Raigetix/EEG_EMT_32/Hardware/EEG/ADC.pdf

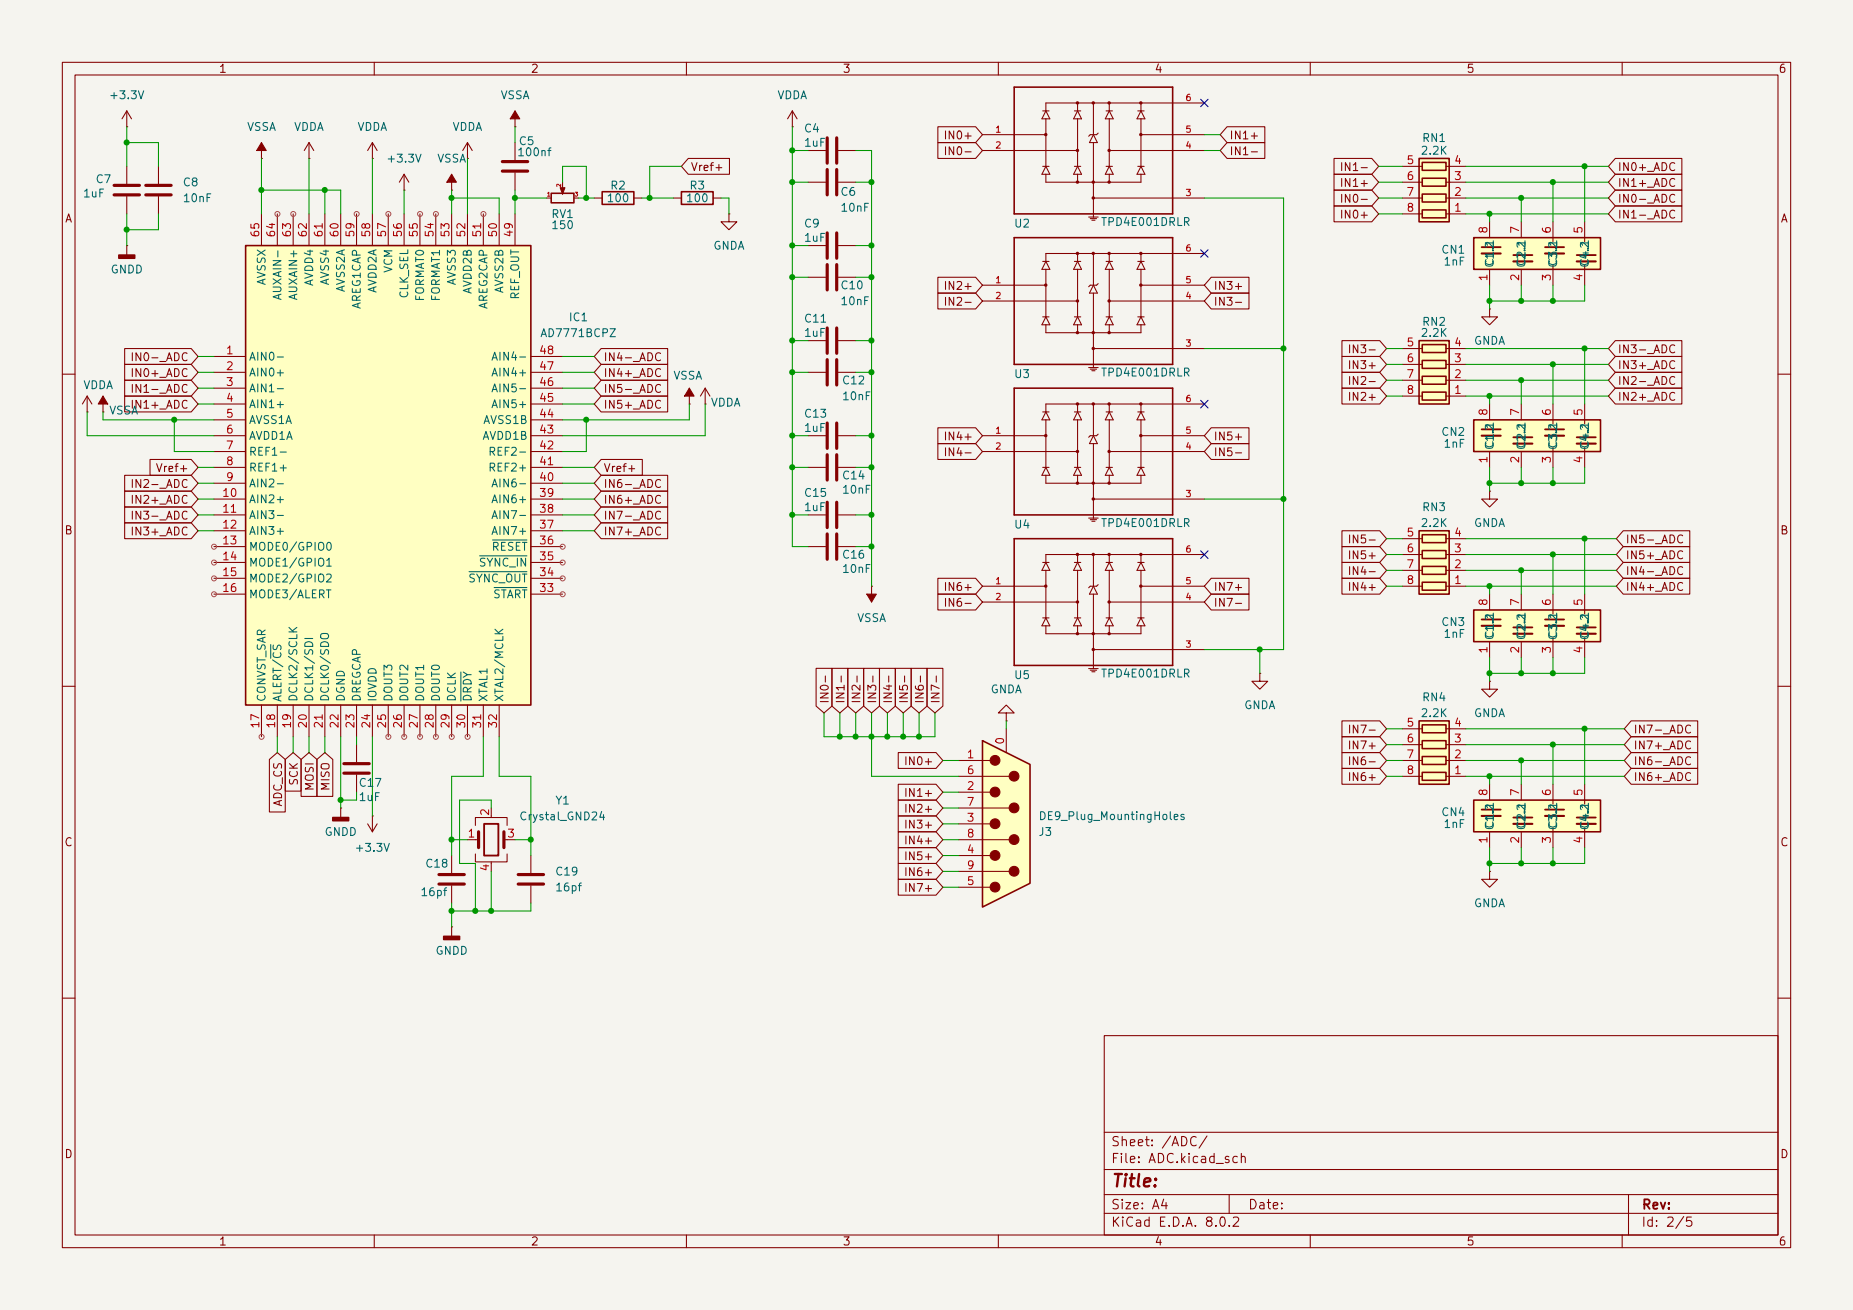
[picture p1: page 1]
