Raigetix/EEG_EMT_32/Hardware/EEG/EEG.kicad_pcb

## KiCad design Hardware/EEG/EEG.kicad_pcb (2025-01-11)

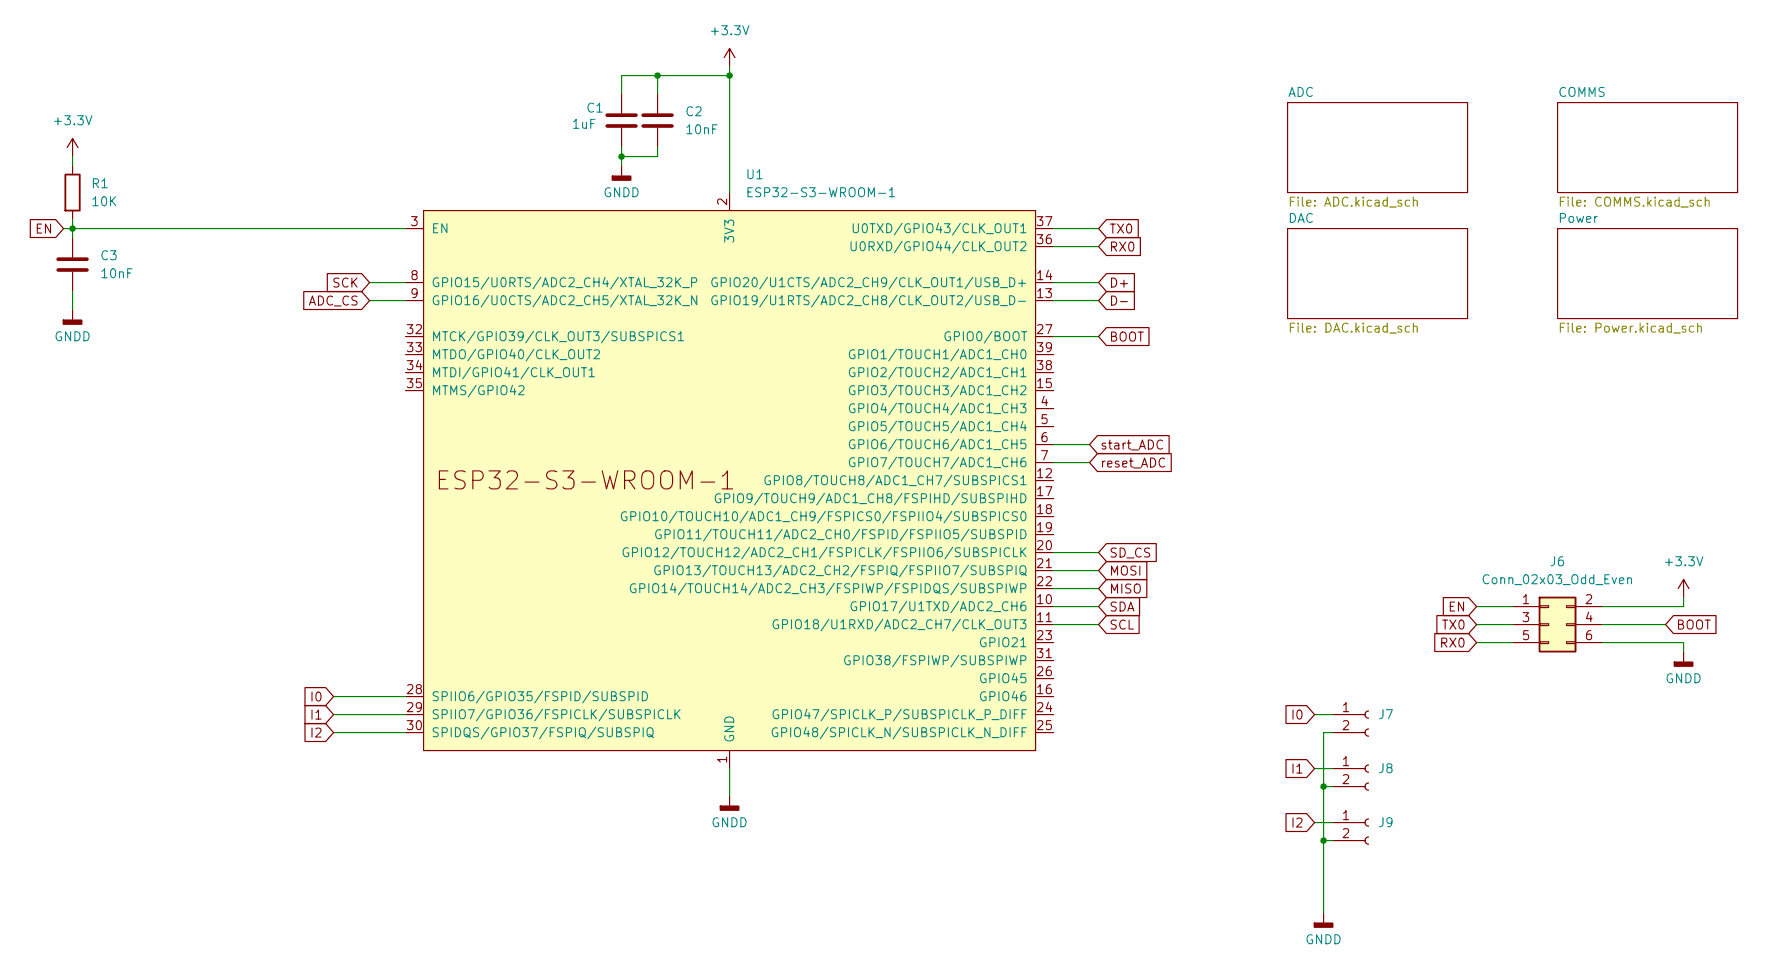
[picture p2: schematic EEG.kicad_sch]

Parts:
C1: 1uF; C_1210_3225Metric_Pad1.33x2.70mm_HandSolder
C2, C3: 10nF; C_0603_1608Metric_Pad1.08x0.95mm_HandSolder
J6: Conn_02x03_Odd_Even; PinHeader_2x03_P2.54mm_Vertical
J7, J8, J9: Conn_01x02_Socket; JST_XA_B02B-XASK-1-A_1x02_P2.50mm_Vertical
R1: 10K; R_0402_1005Metric_Pad0.72x0.64mm_HandSolder
U1: ESP32-S3-WROOM-1

Connections:
+3.3V: C1.1, C2.1, J6.2, R1.1, U1.2 (3V3); also elsewhere on the board
ADC_CS: U1.9 (GPIO16/U0CTS/ADC2_CH5/XTAL_32K_N); also elsewhere on the board
BOOT: J6.4, U1.27 (GPIO0/BOOT)
D+: U1.14 (GPIO20/U1CTS/ADC2_CH9/CLK_OUT1/USB_D+); also elsewhere on the board
D-: U1.13 (GPIO19/U1RTS/ADC2_CH8/CLK_OUT2/USB_D-); also elsewhere on the board
EN: C3.1, J6.1, R1.2, U1.3 (EN)
GNDA: C1.2, C2.2, C3.2, J6.6, J7.2, J8.2, J9.2, U1.1 (GND), U1.40 (GND), U1.41 (GND); also elsewhere on the board
I0: J7.1, U1.28 (SPIIO6/GPIO35/FSPID/SUBSPID)
I1: J8.1, U1.29 (SPIIO7/GPIO36/FSPICLK/SUBSPICLK)
I2: J9.1, U1.30 (SPIDQS/GPIO37/FSPIQ/SUBSPIQ)
MISO: U1.22 (GPIO14/TOUCH14/ADC2_CH3/FSPIWP/FSPIDQS/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); also elsewhere on the board
MOSI: U1.21 (GPIO13/TOUCH13/ADC2_CH2/FSPIQ/FSPIIO7/S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); also elsewhere on the board
RX0: J6.5, U1.36 (U0RXD/GPIO44/CLK_OUT2)
SCK: U1.8 (GPIO15/U0RTS/ADC2_CH4/XTAL_32K_P); also elsewhere on the board
SCL: U1.11 (GPIO18/U1RXD/ADC2_CH7/CLK_OUT3); also elsewhere on the board
SDA: U1.10 (GPIO17/U1TXD/ADC2_CH6); also elsewhere on the board
SD_CS: U1.20 (GPIO12/TOUCH12/ADC2_CH1/FSPICLK/FSPIIO6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); also elsewhere on the board
TX0: J6.3, U1.37 (U0TXD/GPIO43/CLK_OUT1)
reset_ADC: U1.7 (GPIO7/TOUCH7/ADC1_CH6); also elsewhere on the board
start_ADC: U1.6 (GPIO6/TOUCH6/ADC1_CH5); also elsewhere on the board

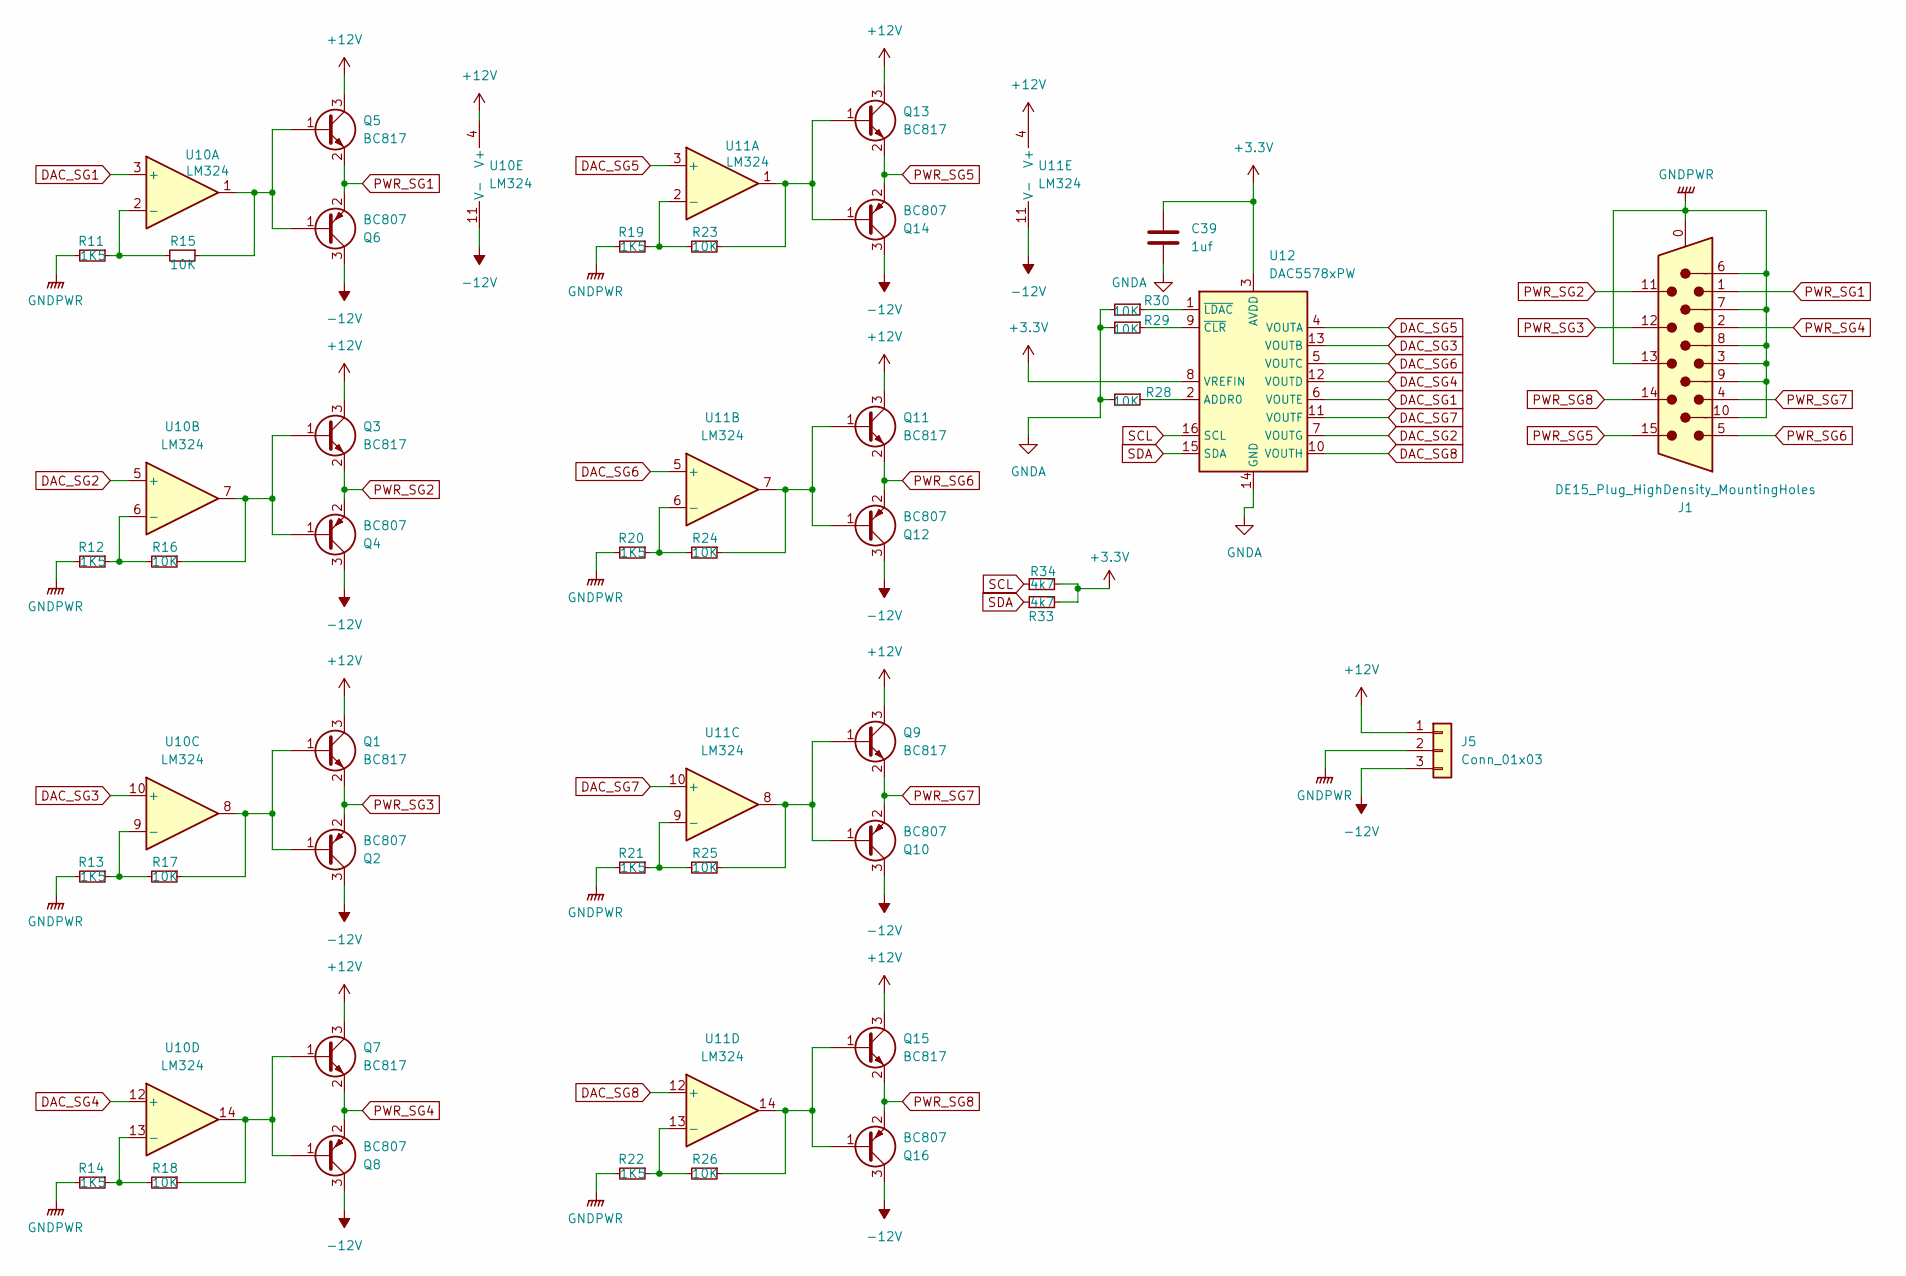
[picture p3: schematic DAC.kicad_sch]

Parts:
C39: 1uf; C_0603_1608Metric_Pad1.08x0.95mm_HandSolder
J1: DE15_Plug_HighDensity_MountingHoles; DSUB-15-HD_Female_Horizontal_P2.29x1.98mm_EdgePinOffset3.03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
J5: Conn_01x03; TerminalBlock_Phoenix_MKDS-1,5-3_1x03_P5.00mm_Horizontal
Q1, Q3, Q5, Q7, Q9, Q11, Q13, Q15: BC817; SOT-23
Q2, Q4, Q6, Q8, Q10, Q12, Q14, Q16: BC807; SOT-23
R11, R12, R13, R14, R19, R20, R21, R22: 1K5; R_0402_1005Metric_Pad0.72x0.64mm_HandSolder
R15, R16, R17, R18, R23, R24, R25, R26, R28, R29, R30: 10K; R_0402_1005Metric_Pad0.72x0.64mm_HandSolder
R33, R34: 4k7; R_0402_1005Metric_Pad0.72x0.64mm_HandSolder
U10, U11: LM324; TSSOP-14_4.4x5mm_P0.65mm
U12: DAC5578xPW; TSSOP-16_4.4x5mm_P0.65mm

Connections:
+3.3V: C39.1, R33.2, R34.2, U12.3 (AVDD), U12.8 (VREFIN); also elsewhere on the board
+12V: J5.1, Q1.3 (C), Q3.3 (C), Q5.3 (C), Q7.3 (C), Q9.3 (C), Q11.3 (C), Q13.3 (C), Q15.3 (C), U10.4 (V+), U11.4 (V+)
-12V: J5.3, Q2.3 (C), Q4.3 (C), Q6.3 (C), Q8.3 (C), Q10.3 (C), Q12.3 (C), Q14.3 (C), Q16.3 (C), U10.11 (V-), U11.11 (V-)
DAC_SG1: U10.3 (+), U12.6 (VOUTE)
DAC_SG2: U10.5 (+), U12.7 (VOUTG)
DAC_SG3: U10.10 (+), U12.13 (VOUTB)
DAC_SG4: U10.12 (+), U12.12 (VOUTD)
DAC_SG5: U11.3 (+), U12.4 (VOUTA)
DAC_SG6: U11.5 (+), U12.5 (VOUTC)
DAC_SG7: U11.10 (+), U12.11 (VOUTF)
DAC_SG8: U11.12 (+), U12.10 (VOUTH)
GNDA: C39.2, J1.0, J1.3, J1.6, J1.7, J1.8, J1.9, J1.10, J1.13, J5.2, R11.2, R12.2, R13.2, R14.2, R19.2, R20.2, R21.2, R22.2, R28.2, R29.2, R30.2, U12.14 (GND); also elsewhere on the board
unnamed: Q1.1 (B), Q2.1 (B), R17.1, U10.8
unnamed: Q3.1 (B), Q4.1 (B), R16.1, U10.7
unnamed: Q5.1 (B), Q6.1 (B), R15.1, U10.1
unnamed: Q7.1 (B), Q8.1 (B), R18.1, U10.14
unnamed: Q9.1 (B), Q10.1 (B), R25.1, U11.8
unnamed: Q11.1 (B), Q12.1 (B), R24.1, U11.7
unnamed: Q13.1 (B), Q14.1 (B), R23.1, U11.1
unnamed: Q15.1 (B), Q16.1 (B), R26.1, U11.14
unnamed: R11.1, R15.2, U10.2 (-)
unnamed: R12.1, R16.2, U10.6 (-)
unnamed: R13.1, R17.2, U10.9 (-)
unnamed: R14.1, R18.2, U10.13 (-)
unnamed: R19.1, R23.2, U11.2 (-)
unnamed: R20.1, R24.2, U11.6 (-)
unnamed: R21.1, R25.2, U11.9 (-)
unnamed: R22.1, R26.2, U11.13 (-)
unnamed: R28.1, U12.2 (ADDR0)
unnamed: R29.1, U12.9 (~CLR)
unnamed: R30.1, U12.1 (~LDAC)
PWR_SG1: J1.1, Q5.2 (E), Q6.2 (E)
PWR_SG2: J1.11, Q3.2 (E), Q4.2 (E)
PWR_SG3: J1.12, Q1.2 (E), Q2.2 (E)
PWR_SG4: J1.2, Q7.2 (E), Q8.2 (E)
PWR_SG5: J1.15, Q13.2 (E), Q14.2 (E)
PWR_SG6: J1.5, Q11.2 (E), Q12.2 (E)
PWR_SG7: J1.4, Q9.2 (E), Q10.2 (E)
PWR_SG8: J1.14, Q15.2 (E), Q16.2 (E)
SCL: R34.1, U12.16 (SCL); also elsewhere on the board
SDA: R33.1, U12.15 (SDA); also elsewhere on the board

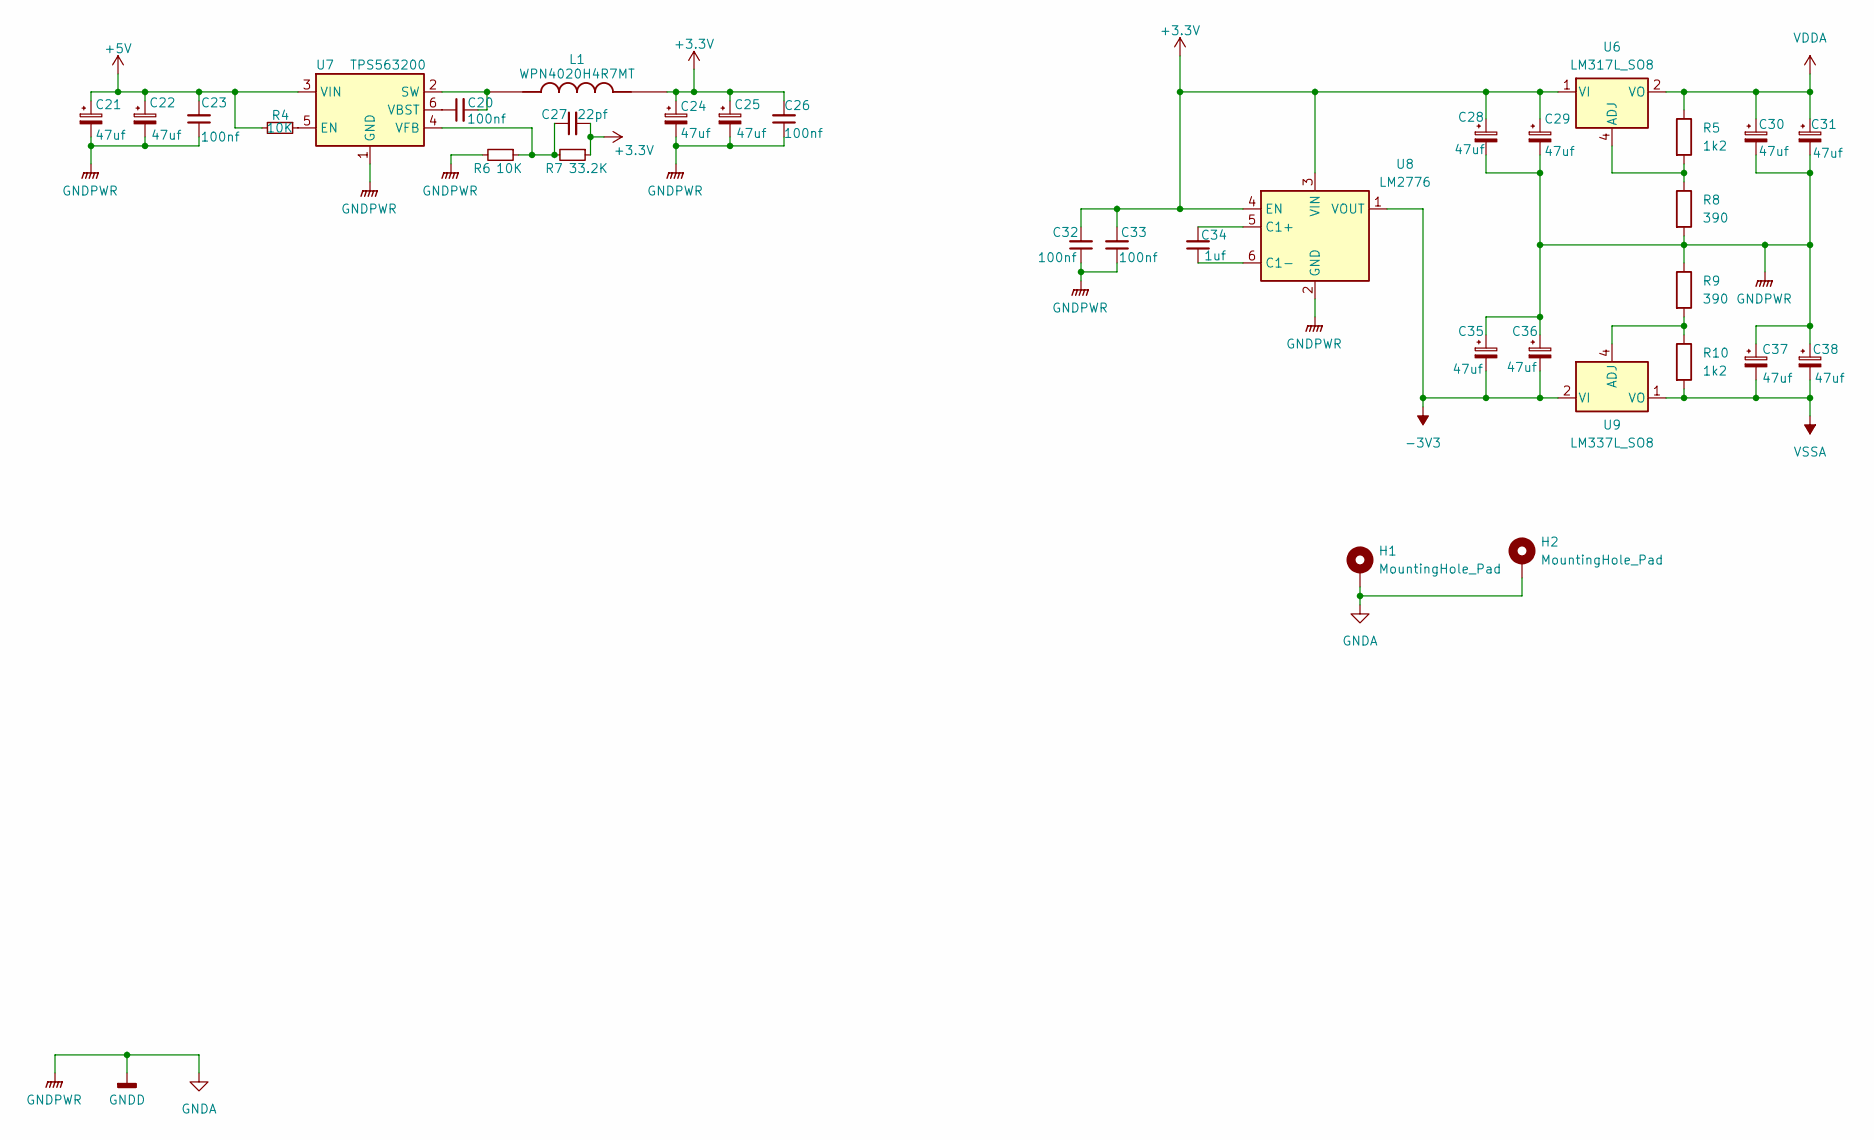
[picture p4: schematic Power.kicad_sch]

Parts:
C20, C23, C26, C32, C33: 100nf; L_0402_1005Metric_Pad0.77x0.64mm_HandSolder
C21, C22, C24, C25, C28, C29, C30, C31, C35, C36, C37, C38: 47uf; C_1210_3225Metric_Pad1.33x2.70mm_HandSolder
C27: 22pf; L_0402_1005Metric_Pad0.77x0.64mm_HandSolder
C34: 1uf; L_0402_1005Metric_Pad0.77x0.64mm_HandSolder
H1, H2: MountingHole_Pad; MountingHole_3.2mm_M3_Pad_Via
L1: WPN4020H4R7MT; L_Vishay_IFSC-1515AH_4x4x1.8mm; PARTREV 1
R4, R6: 10K; R_0402_1005Metric_Pad0.72x0.64mm_HandSolder
R5, R10: 1k2; R_0603_1608Metric_Pad0.98x0.95mm_HandSolder
R7: 33.2K; R_0402_1005Metric_Pad0.72x0.64mm_HandSolder
R8, R9: 390; R_0603_1608Metric_Pad0.98x0.95mm_HandSolder
U6: LM317L_SO8; SOIC-8_3.9x4.9mm_P1.27mm
U7: TPS563200; SOT-23-6
U8: LM2776; SOT-23-6
U9: LM337L_SO8; SOIC-8_3.9x4.9mm_P1.27mm

Connections:
+3.3V: C24.1, C25.1, C26.2, C27.2, C28.1, C29.1, C32.2, C33.2, L1.2, R7.1, U6.1 (VI), U8.3 (VIN), U8.4 (EN); also elsewhere on the board
+5V: C21.1, C22.1, C23.2, R4.2, U7.3 (VIN); also elsewhere on the board
-3V3: C35.2, C36.2, U8.1 (VOUT), U9.2 (VI), U9.3 (VI), U9.6 (VI), U9.7 (VI)
GNDA: C21.2, C22.2, C23.1, C24.2, C25.2, C26.1, C28.2, C29.2, C30.2, C31.2, C32.1, C33.1, C35.1, C36.1, C37.1, C38.1, H1.1, H2.1, R6.2, R8.2, R9.1, U7.1 (GND), U8.2 (GND); also elsewhere on the board
unnamed: R5.2, R8.1, U6.4 (ADJ)
unnamed: R4.1, U7.5 (EN)
unnamed: C20.2, L1.1, U7.2 (SW)
unnamed: C20.1, U7.6 (VBST)
unnamed: C27.1, R6.1, R7.2, U7.4 (VFB)
unnamed: C34.2, U8.5 (C1+)
unnamed: C34.1, U8.6 (C1-)
unnamed: R9.2, R10.1, U9.4 (ADJ)
VDDA: C30.1, C31.1, R5.1, U6.2 (VO), U6.3 (VO), U6.6 (VO), U6.7 (VO); also elsewhere on the board
VSSA: C37.2, C38.2, R10.2, U9.1 (VO); also elsewhere on the board

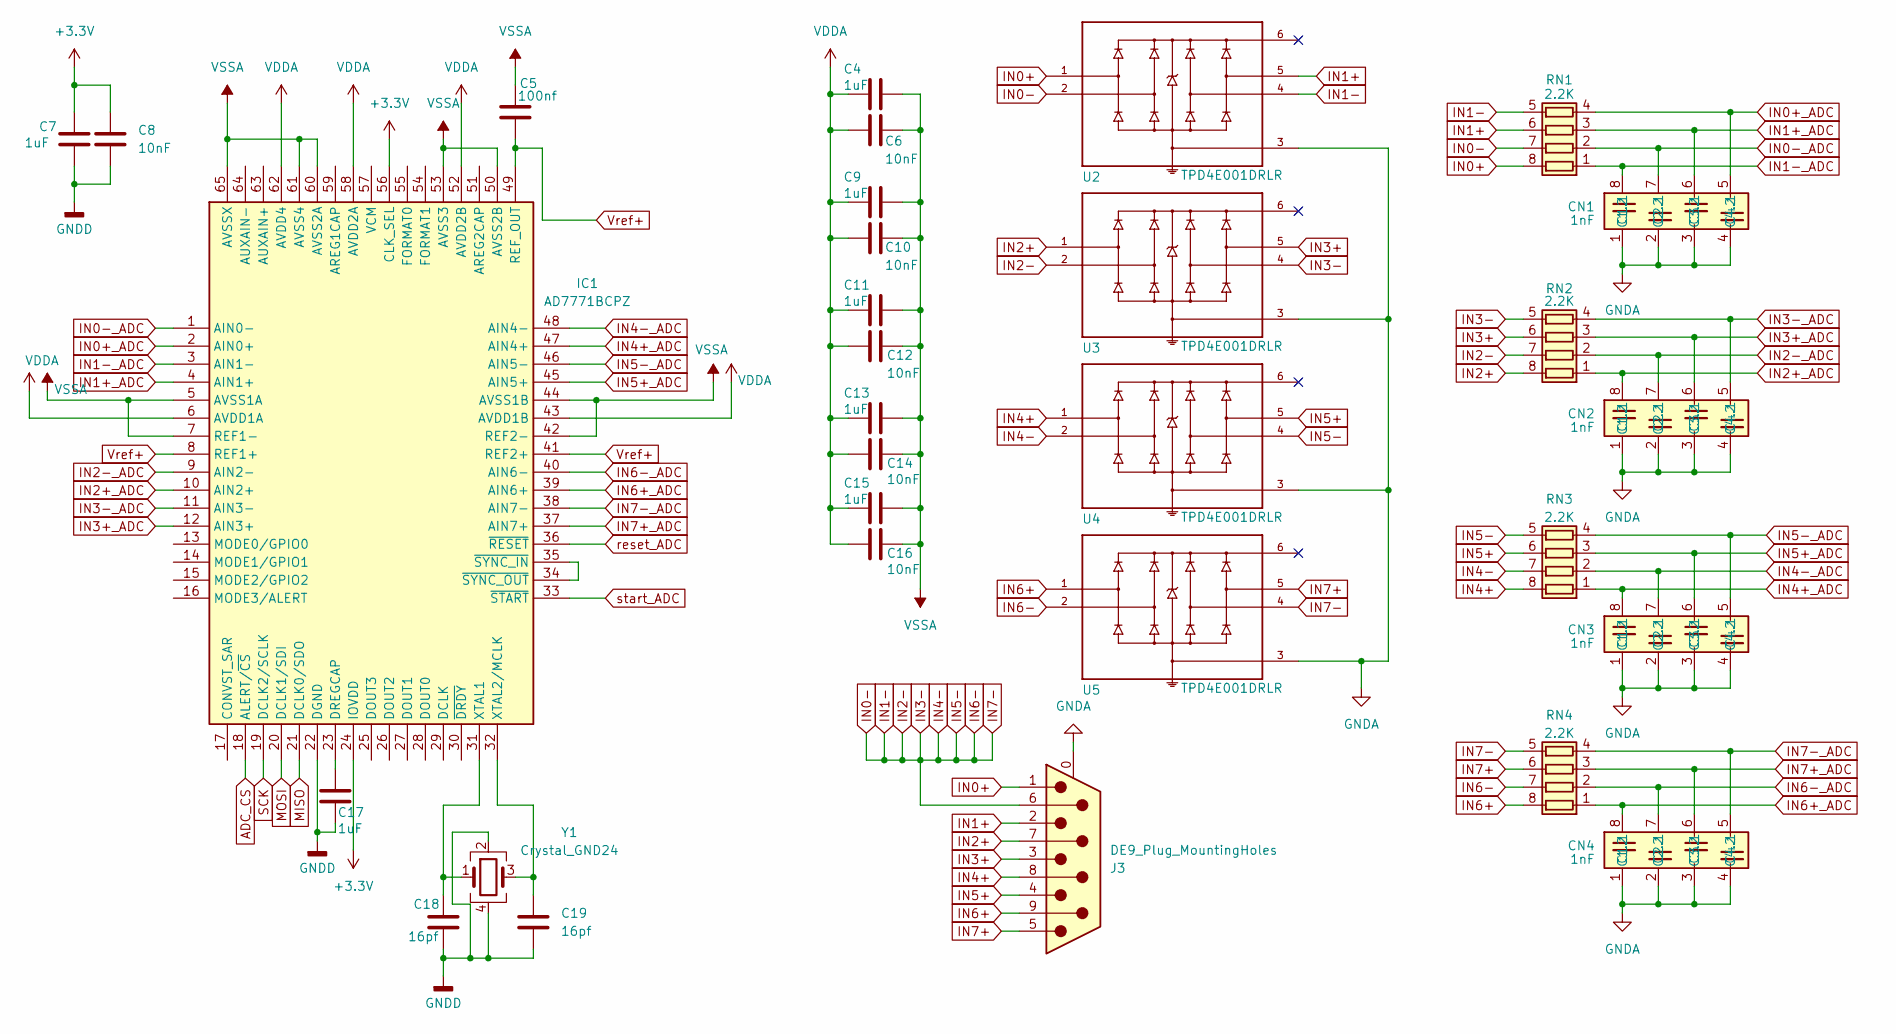
[picture p5: schematic ADC.kicad_sch]

Parts:
C4, C9, C11, C13, C15, C17: 1uF; C_0603_1608Metric_Pad1.08x0.95mm_HandSolder
C5: 100nf; C_0402_1005Metric_Pad0.74x0.62mm_HandSolder
C6, C8, C10, C12, C14, C16: 10nF; C_0603_1608Metric_Pad1.08x0.95mm_HandSolder
C7: 1uF; C_1210_3225Metric_Pad1.33x2.70mm_HandSolder
C18, C19: 16pf; C_0402_1005Metric_Pad0.74x0.62mm_HandSolder
CN1: 1nF; R_Array_Convex_4x0603
CN2, CN3, CN4: 1nF; R_Array_Concave_4x0603
IC1: AD7771BCPZ; QFN-64-1EP_9x9mm_P0.5mm_EP7.35x7.35mm; Manufacturer_Part_Number AD7771BCPZ; Mouser Part Number 584-AD7771BCPZ
J3: DE9_Plug_MountingHoles; DSUB-9_Female_Horizontal_P2.77x2.84mm_EdgePinOffset4.94mm_H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
RN1, RN2, RN3, RN4: 2.2K; R_Array_Concave_4x0603
U2, U3, U4, U5: TPD4E001DRLR; Texas_R-PDSO-N6_DRL-6
Y1: Crystal_GND24; Crystal_SMD_SeikoEpson_FA238V-4Pin_3.2x2.5mm

Connections:
+3.3V: C7.1, C8.1, IC1.24 (IOVDD), IC1.56 (CLK_SEL); also elsewhere on the board
ADC_CS: IC1.18 (ALERT/~CS); also elsewhere on the board
GNDA: C7.2, C8.2, C17.2, C18.2, C19.2, CN1.1 (C1.1), CN1.2 (C2.1), CN1.3 (C3.1), CN1.4 (C4.1), CN2.1 (C1.1), CN2.2 (C2.1), CN2.3 (C3.1), CN2.4 (C4.1), CN3.1 (C1.1), CN3.2 (C2.1), CN3.3 (C3.1), CN3.4 (C4.1), CN4.1 (C1.1), CN4.2 (C2.1), CN4.3 (C3.1), CN4.4 (C4.1), IC1.22 (DGND), J3.0 (PAD), U2.3, U3.3, U4.3, U5.3, Y1.2, Y1.4; also elsewhere on the board
IN0+: J3.1, RN1.8 (R1.2), U2.1
IN0+_ADC: CN1.5 (C4.2), IC1.2 (AIN0+), RN1.4 (R4.1)
IN0-: J3.6, RN1.5 (R4.2), RN1.7 (R2.2), RN2.5 (R4.2), RN2.7 (R2.2), RN3.5 (R4.2), RN3.7 (R2.2), RN4.5 (R4.2), RN4.7 (R2.2), U2.2, U2.4, U3.2, U3.4, U4.2, U4.4, U5.2, U5.4
IN0-_ADC: CN1.7 (C2.2), IC1.1 (AIN0-), RN1.2 (R2.1)
IN1+: J3.2, RN1.6 (R3.2), U2.5
IN1+_ADC: CN1.6 (C3.2), IC1.4 (AIN1+), RN1.3 (R3.1)
IN1-_ADC: CN1.8 (C1.2), IC1.3 (AIN1-), RN1.1 (R1.1)
IN2+: J3.7, RN2.8 (R1.2), U3.1
IN2+_ADC: CN2.8 (C1.2), IC1.10 (AIN2+), RN2.1 (R1.1)
IN2-_ADC: CN2.7 (C2.2), IC1.9 (AIN2-), RN2.2 (R2.1)
IN3+: J3.3, RN2.6 (R3.2), U3.5
IN3+_ADC: CN2.6 (C3.2), IC1.12 (AIN3+), RN2.3 (R3.1)
IN3-_ADC: CN2.5 (C4.2), IC1.11 (AIN3-), RN2.4 (R4.1)
IN4+: J3.8, RN3.8 (R1.2), U4.1
IN4+_ADC: CN3.8 (C1.2), IC1.47 (AIN4+), RN3.1 (R1.1)
IN4-_ADC: CN3.7 (C2.2), IC1.48 (AIN4-), RN3.2 (R2.1)
IN5+: J3.4, RN3.6 (R3.2), U4.5
IN5+_ADC: CN3.6 (C3.2), IC1.45 (AIN5+), RN3.3 (R3.1)
IN5-_ADC: CN3.5 (C4.2), IC1.46 (AIN5-), RN3.4 (R4.1)
IN6+: J3.9, RN4.8 (R1.2), U5.1
IN6+_ADC: CN4.8 (C1.2), IC1.39 (AIN6+), RN4.1 (R1.1)
IN6-_ADC: CN4.7 (C2.2), IC1.40 (AIN6-), RN4.2 (R2.1)
IN7+: J3.5, RN4.6 (R3.2), U5.5
IN7+_ADC: CN4.6 (C3.2), IC1.37 (AIN7+), RN4.3 (R3.1)
IN7-_ADC: CN4.5 (C4.2), IC1.38 (AIN7-), RN4.4 (R4.1)
MISO: IC1.21 (DCLK0/SDO); also elsewhere on the board
MOSI: IC1.20 (DCLK1/SDI); also elsewhere on the board
unnamed: C17.1, IC1.23 (DREGCAP)
unnamed: C18.1, IC1.31 (XTAL1), Y1.1
unnamed: C19.1, IC1.32 (XTAL2/MCLK), Y1.3
unnamed: IC1.34 (~SYNC_OUT), IC1.35 (~SYNC_IN)
SCK: IC1.19 (DCLK2/SCLK); also elsewhere on the board
VDDA: C4.2, C6.2, C9.2, C10.2, C11.2, C12.2, C13.2, C14.2, C15.2, C16.2, IC1.6 (AVDD1A), IC1.43 (AVDD1B), IC1.52 (AVDD2B), IC1.58 (AVDD2A), IC1.62 (AVDD4); also elsewhere on the board
VSSA: C4.1, C5.1, C6.1, C9.1, C10.1, C11.1, C12.1, C13.1, C14.1, C15.1, C16.1, IC1.5 (AVSS1A), IC1.7 (REF1-), IC1.42 (REF2-), IC1.44 (AVSS1B), IC1.50 (AVSS2B), IC1.53 (AVSS3), IC1.60 (AVSS2A), IC1.61 (AVSS4), IC1.65 (AVSSX); also elsewhere on the board
Vref+: C5.2, IC1.8 (REF1+), IC1.41 (REF2+), IC1.49 (REF_OUT)
reset_ADC: IC1.36 (~RESET); also elsewhere on the board
start_ADC: IC1.33 (~START); also elsewhere on the board

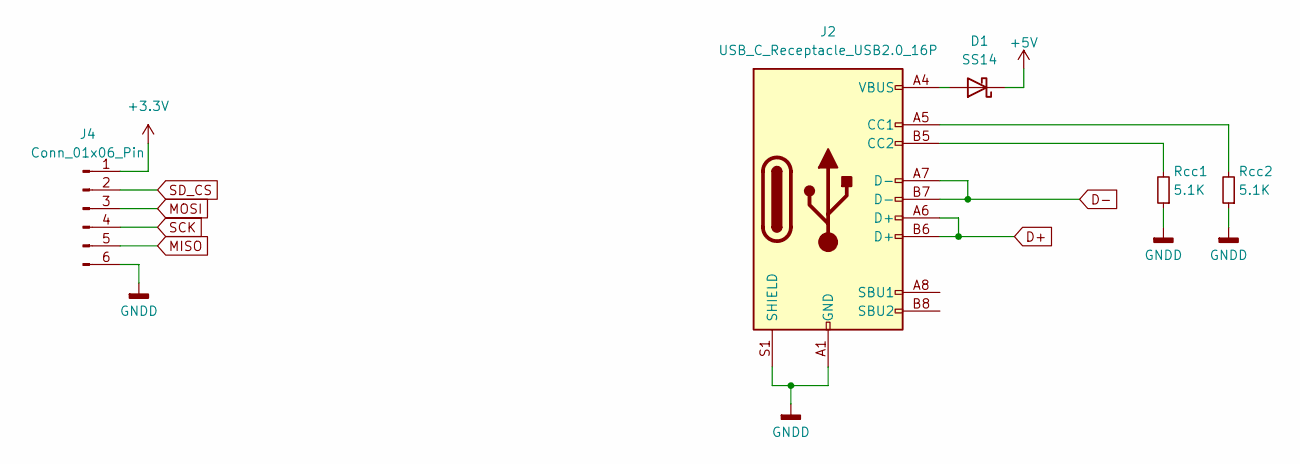
[picture p6: schematic COMMS.kicad_sch]

Parts:
D1: SS14; D_SMA
J2: USB_C_Receptacle_USB2.0_16P; USB_C_Receptacle_Palconn_UTC16-G
J4: Conn_01x06_Pin; PinHeader_1x06_P2.54mm_Vertical
Rcc1, Rcc2: 5.1K; R_0402_1005Metric_Pad0.72x0.64mm_HandSolder

Connections:
+3.3V: J4.1; also elsewhere on the board
+5V: D1.1 (K); also elsewhere on the board
D+: J2.A6 (D+), J2.B6 (D+); also elsewhere on the board
D-: J2.A7 (D-), J2.B7 (D-); also elsewhere on the board
GNDA: J2.A1 (GND), J2.A12 (GND), J2.B1 (GND), J2.B12 (GND), J2.S1 (SHIELD), J4.6, Rcc1.1, Rcc2.1; also elsewhere on the board
MISO: J4.5; also elsewhere on the board
MOSI: J4.3; also elsewhere on the board
unnamed: D1.2 (A), J2.A4 (VBUS), J2.A9 (VBUS), J2.B4 (VBUS), J2.B9 (VBUS)
unnamed: J2.A5 (CC1), Rcc2.2
unnamed: J2.B5 (CC2), Rcc1.2
SCK: J4.4; also elsewhere on the board
SD_CS: J4.2; also elsewhere on the board

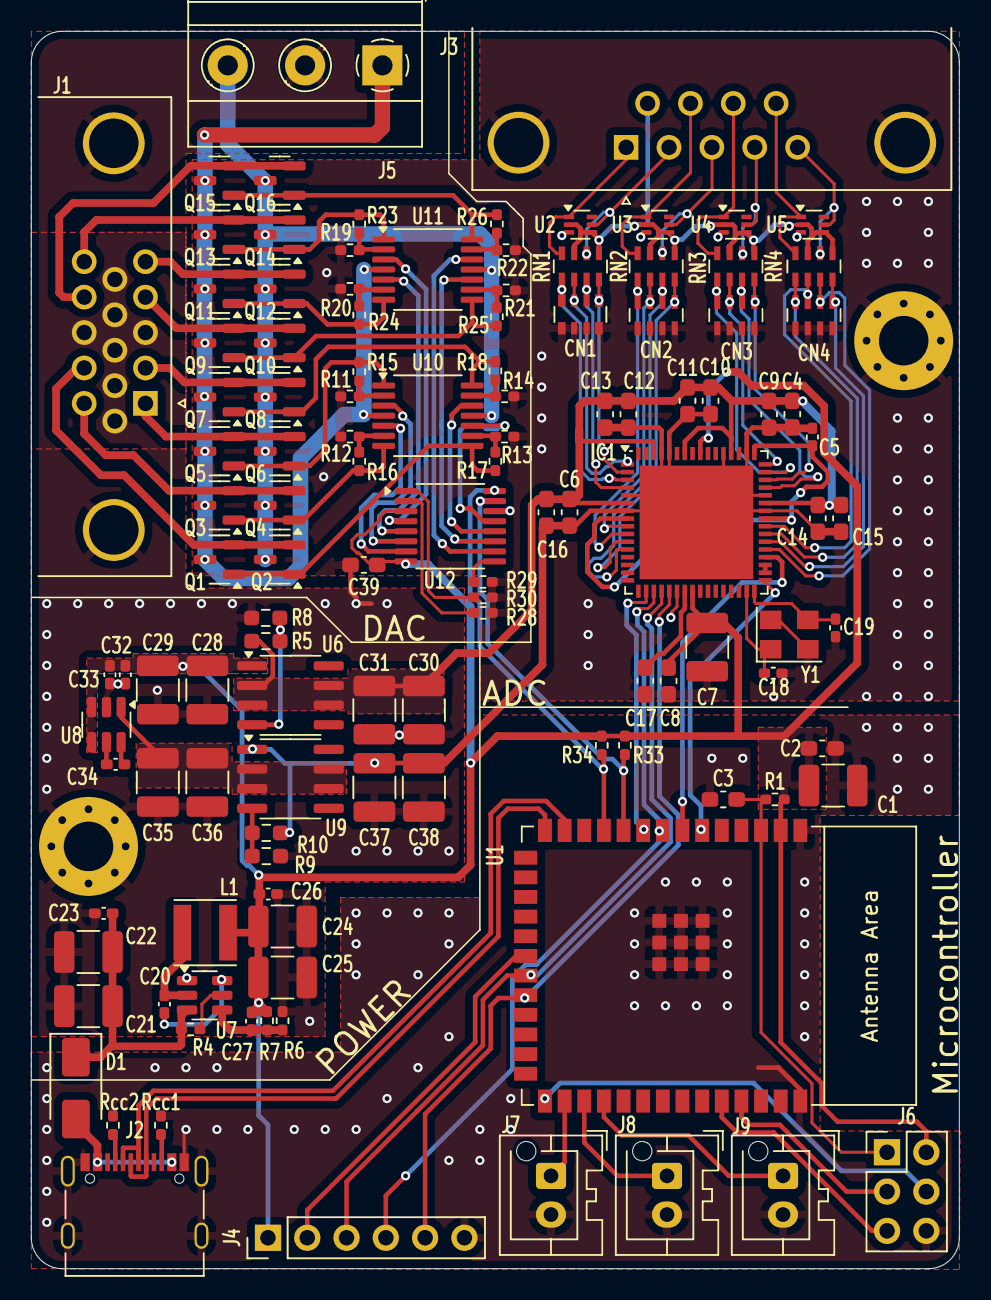
[picture p7: board EEG.kicad_pcb from above]

Board: 2 copper layers, 60.0 x 80.0 mm, 121 parts (0 on the bottom side), 102 nets.
