Raigetix/EEG_EMT_32/(commit log)

2025-01-11 hardware update
    [ADC.kicad_sch, BOM-EEG.csv, COMMS.kicad_sch, DAC.kicad_sch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]
2025-03-12 Compilacion, firmware para leer un solo canal de adc, falta test
2025-03-13 falta control de registros, hay que conectar drdy y sar conv para poder hacer la lectura bien
    [ADC.kicad_sch, COMMS.kicad_sch, DAC.kicad_sch, EEG.kicad_sch, Power.kicad_sch]
2025-03-19 por quinta vez se modifica libreria a lo de NO - OS, falta testing
